JPark82/3xCarbide-Permit-ILK/3xCarbide Permit ILK_Sch(R1.03_1012).pdf

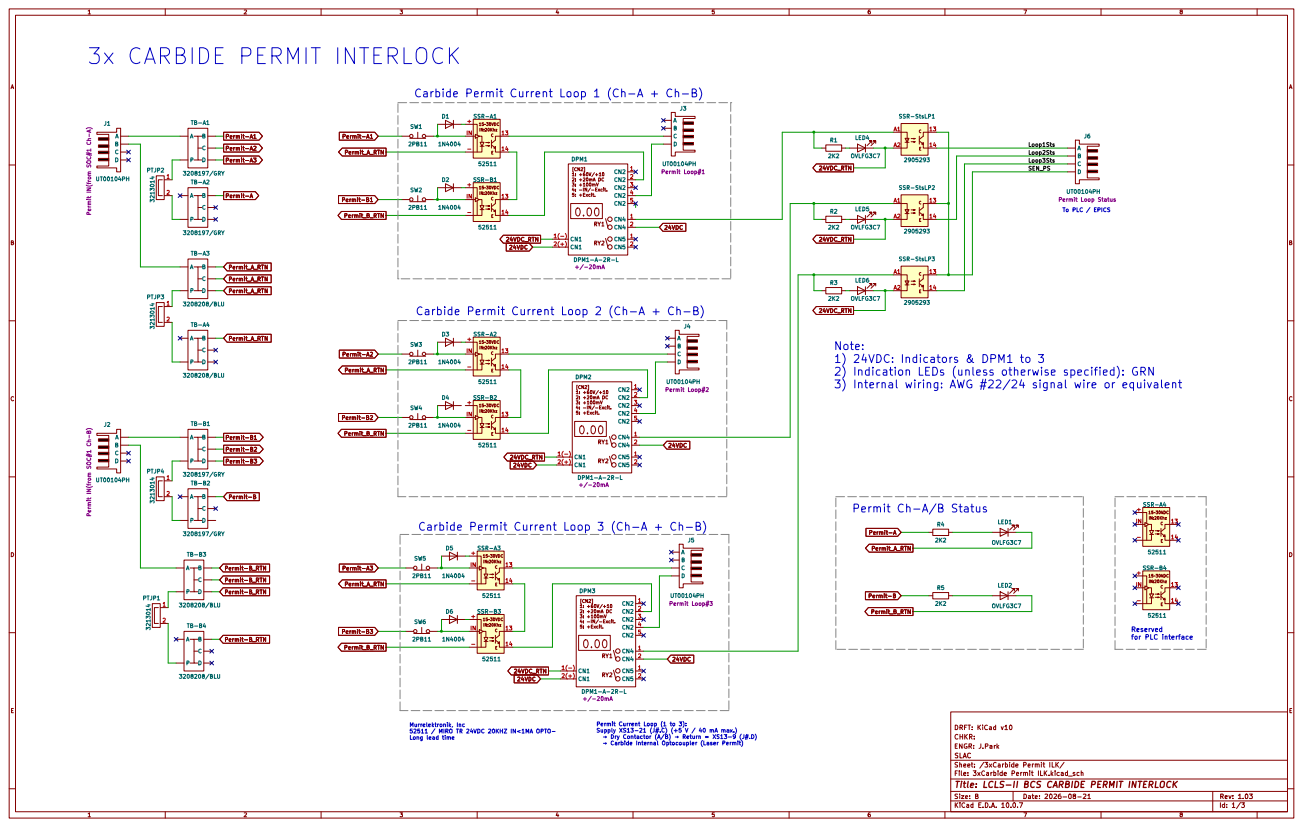
[picture p1: page 1]

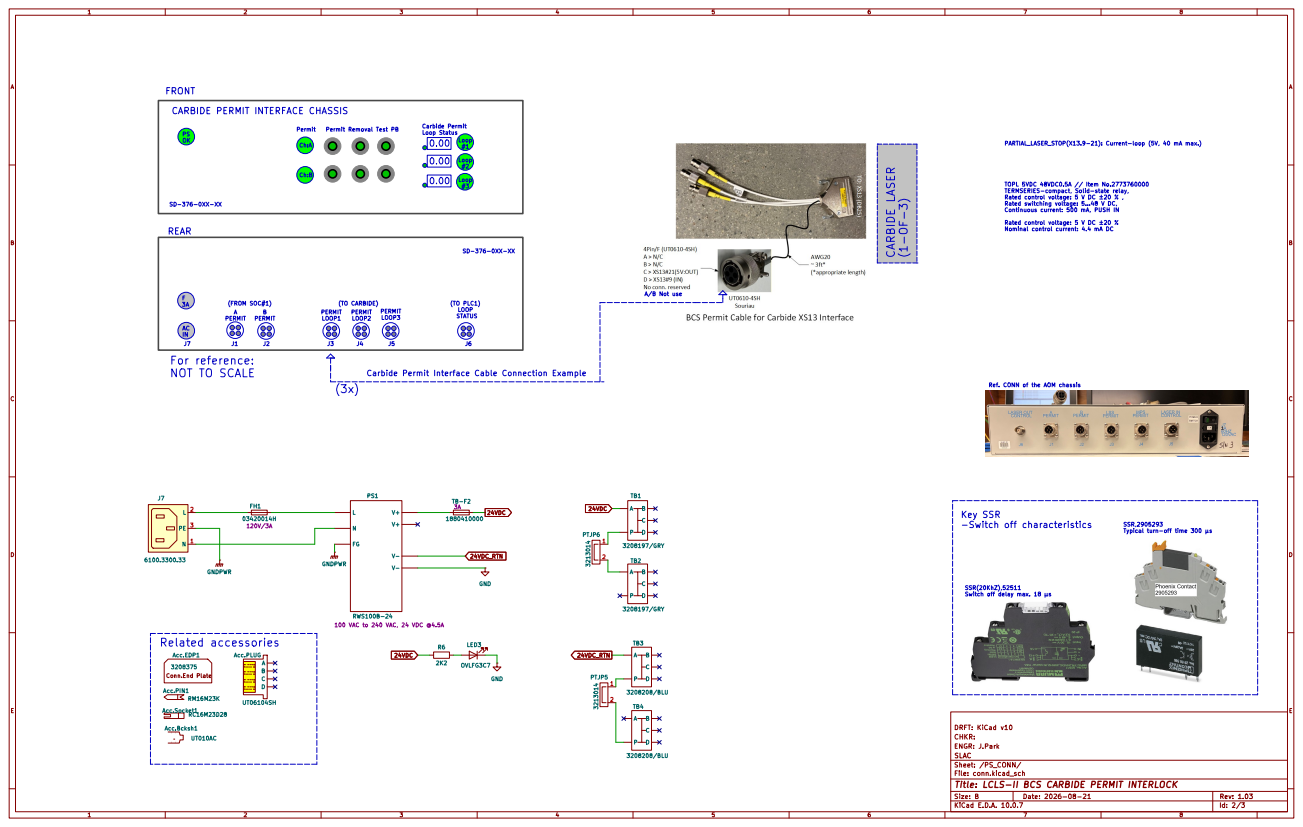
[picture p2: page 2]

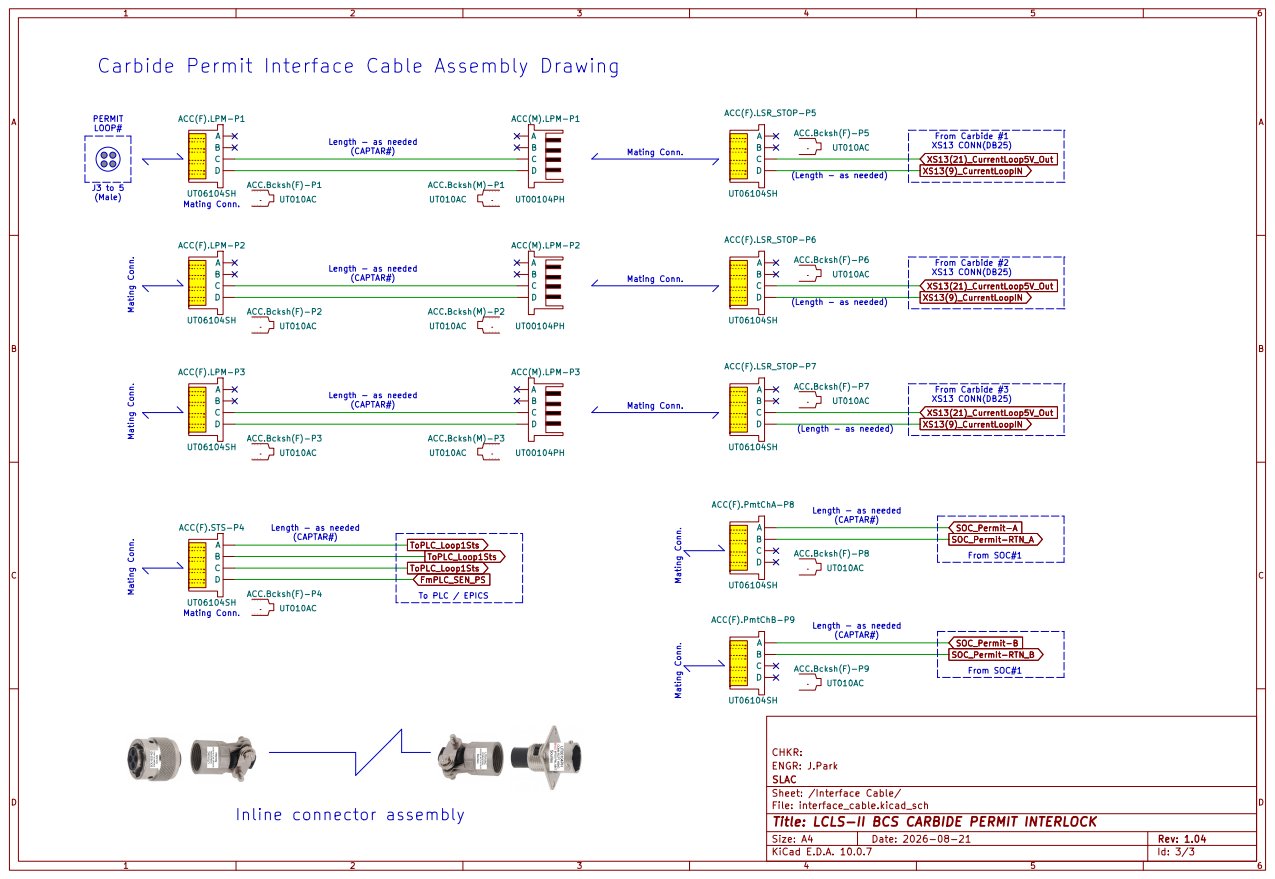
[picture p3: page 3]
