JPark82/3xCarbide-Permit-ILK/3xCarbide Permit ILK_Sch(R1.03_1006).pdf

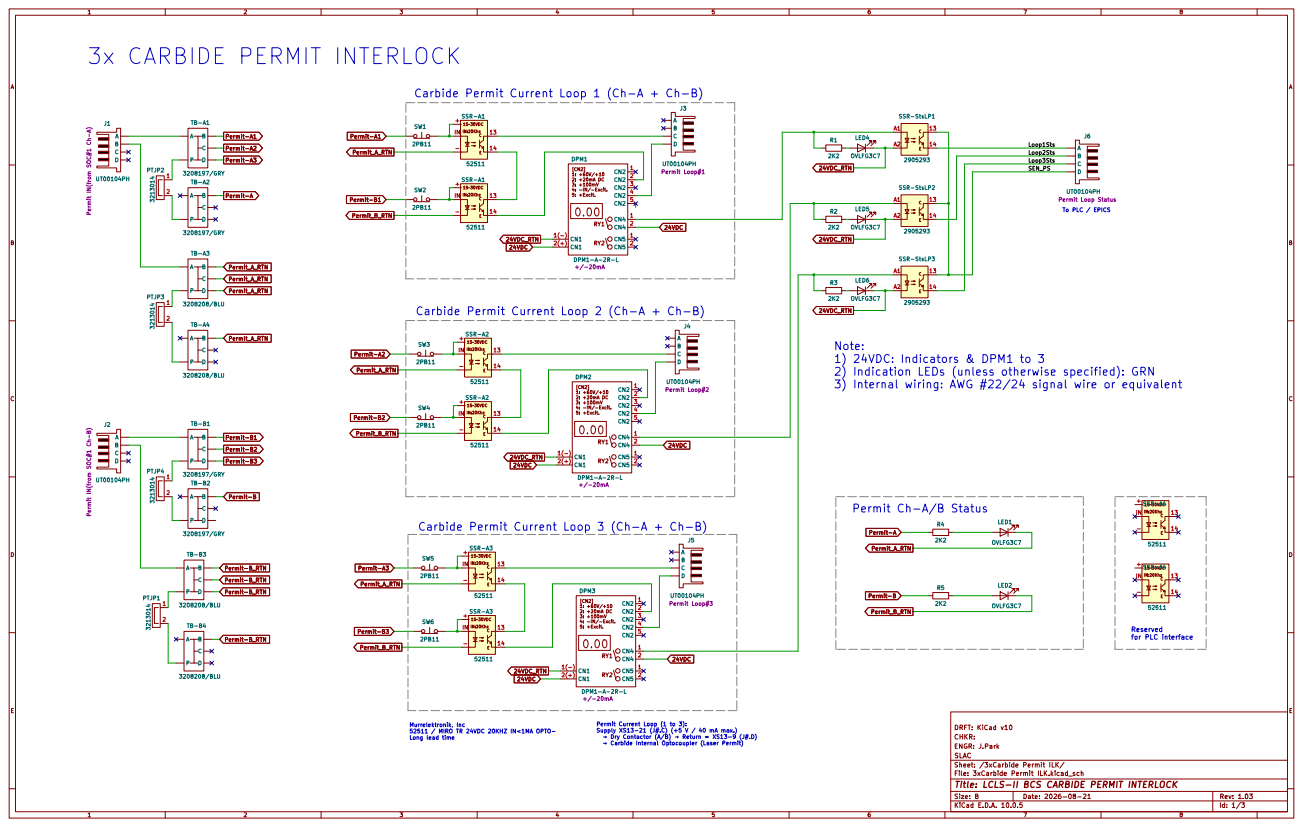
[picture p4: page 1]

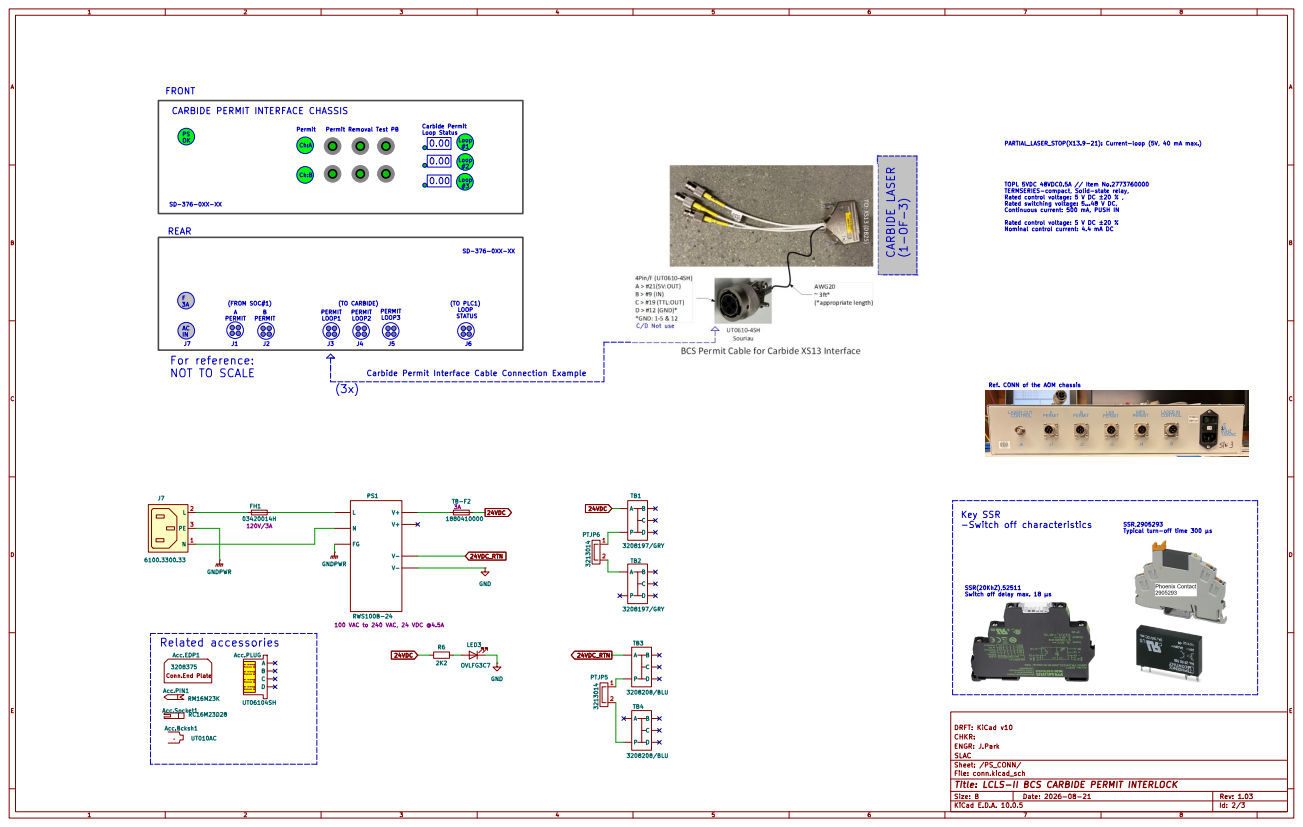
[picture p5: page 2]

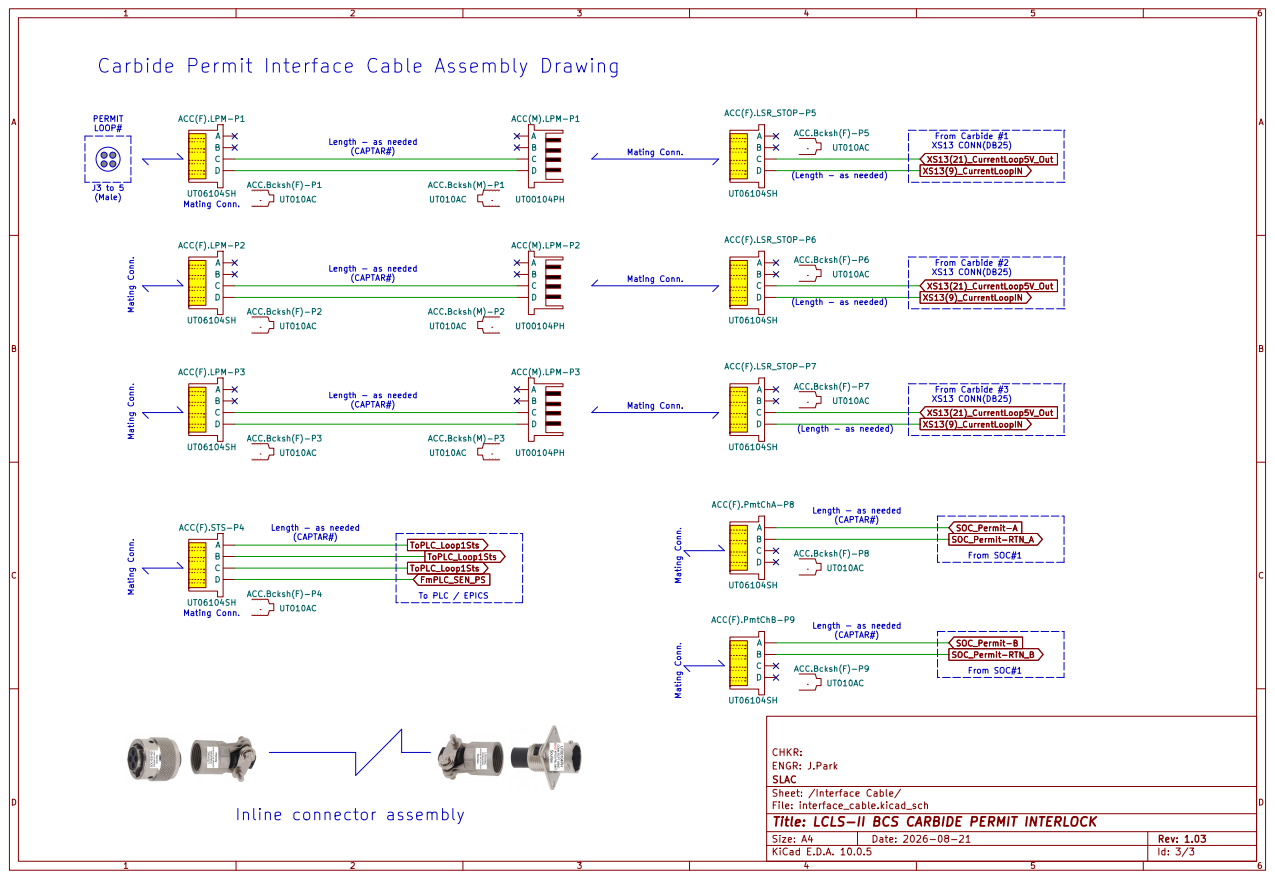
[picture p6: page 3]
