JPark82/3xCarbide-Permit-ILK/3xCarbide Permit ILK_Sch(R1.01_0821).pdf

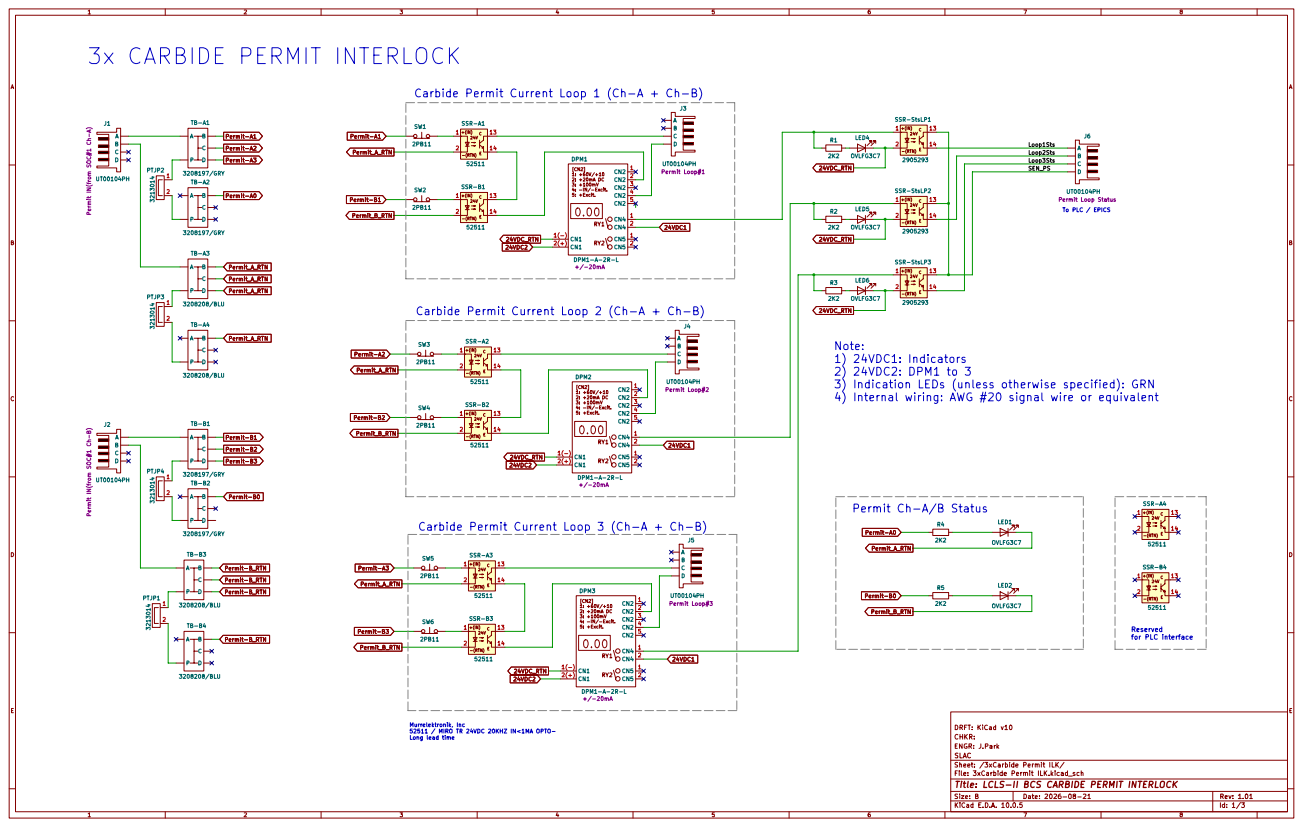
[picture p7: page 1]

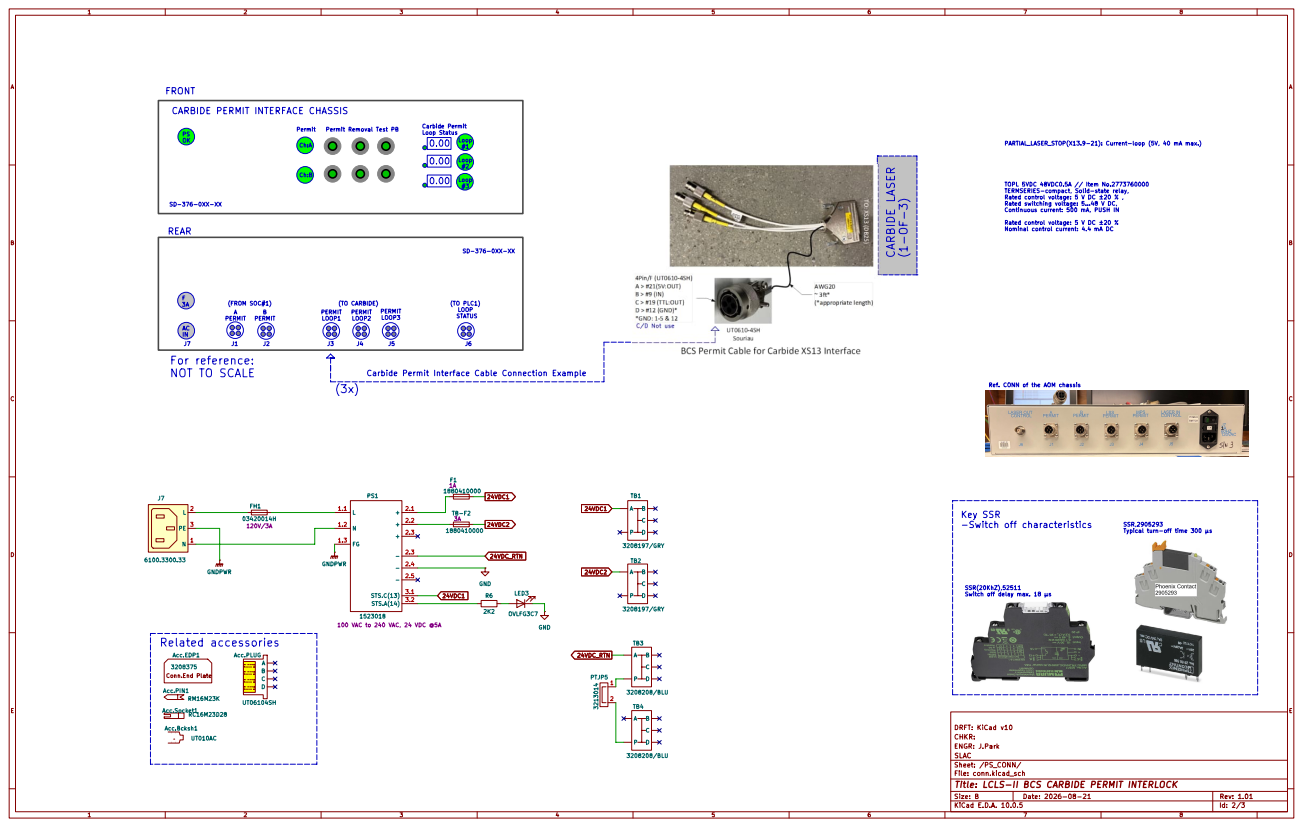
[picture p8: page 2]

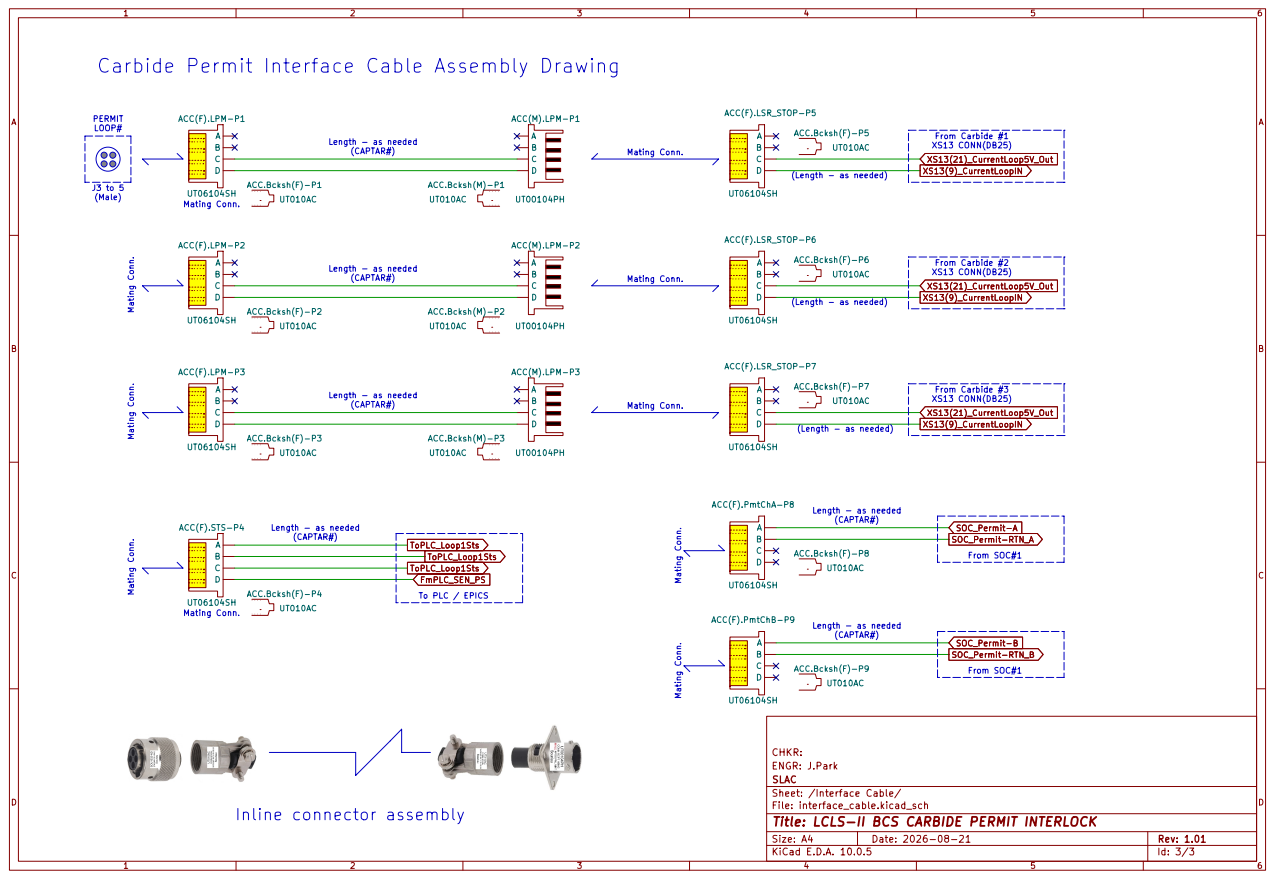
[picture p9: page 3]
