JPark82/3xCarbide-Permit-ILK/3xCarbide Permit ILK_Sch(R1a_0821).pdf

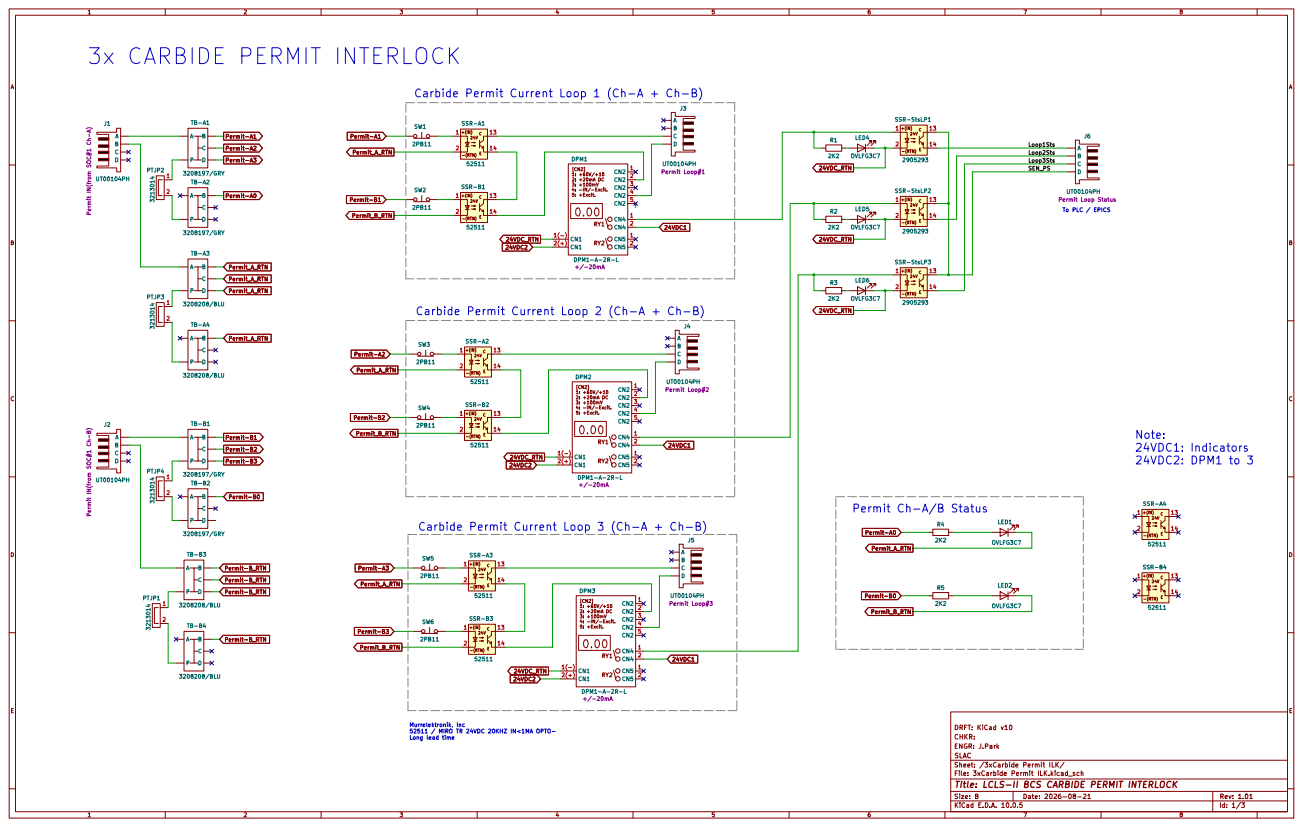
[picture p10: page 1]

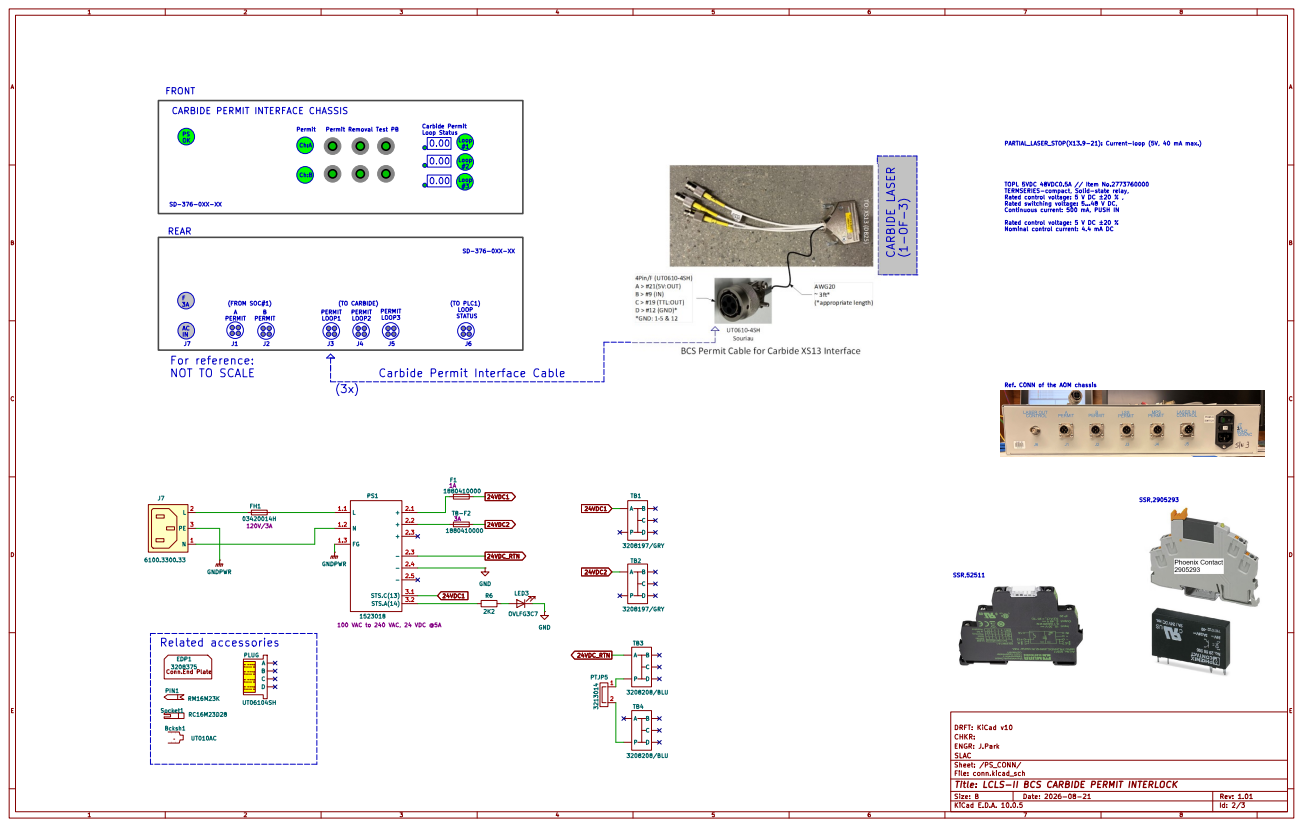
[picture p11: page 2]

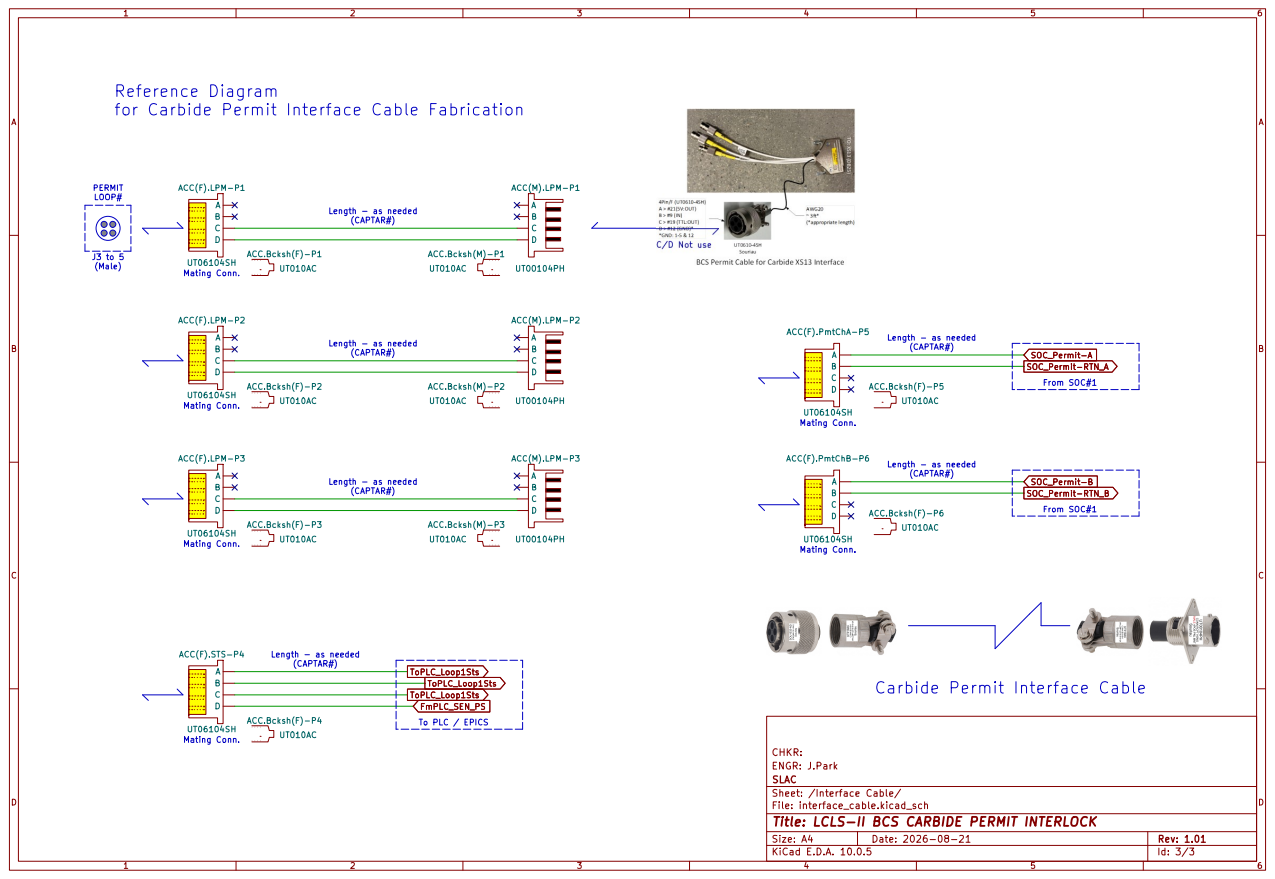
[picture p12: page 3]
