JPark82/3xCarbide-Permit-ILK/3xCarbide Permit ILK_Sch(R1a_0820).pdf

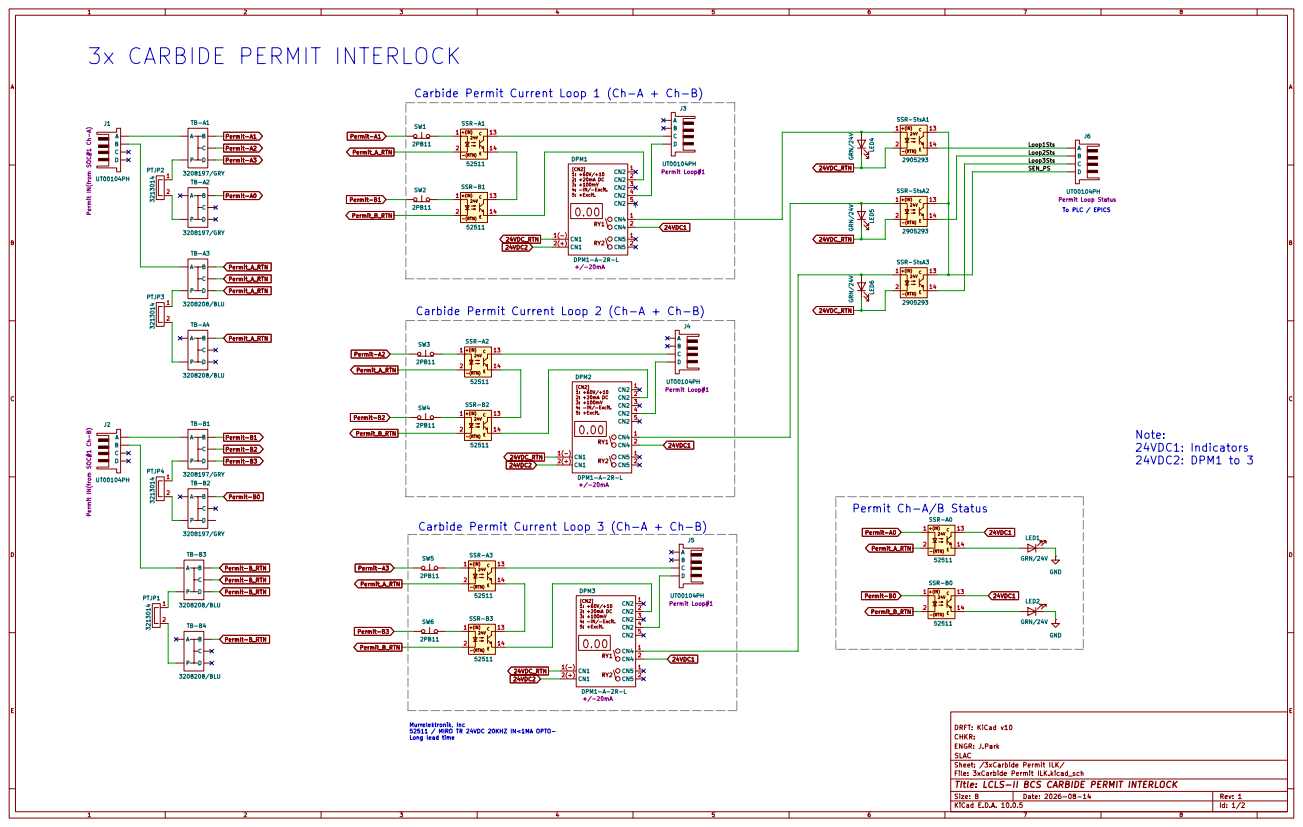
[picture p13: page 1]

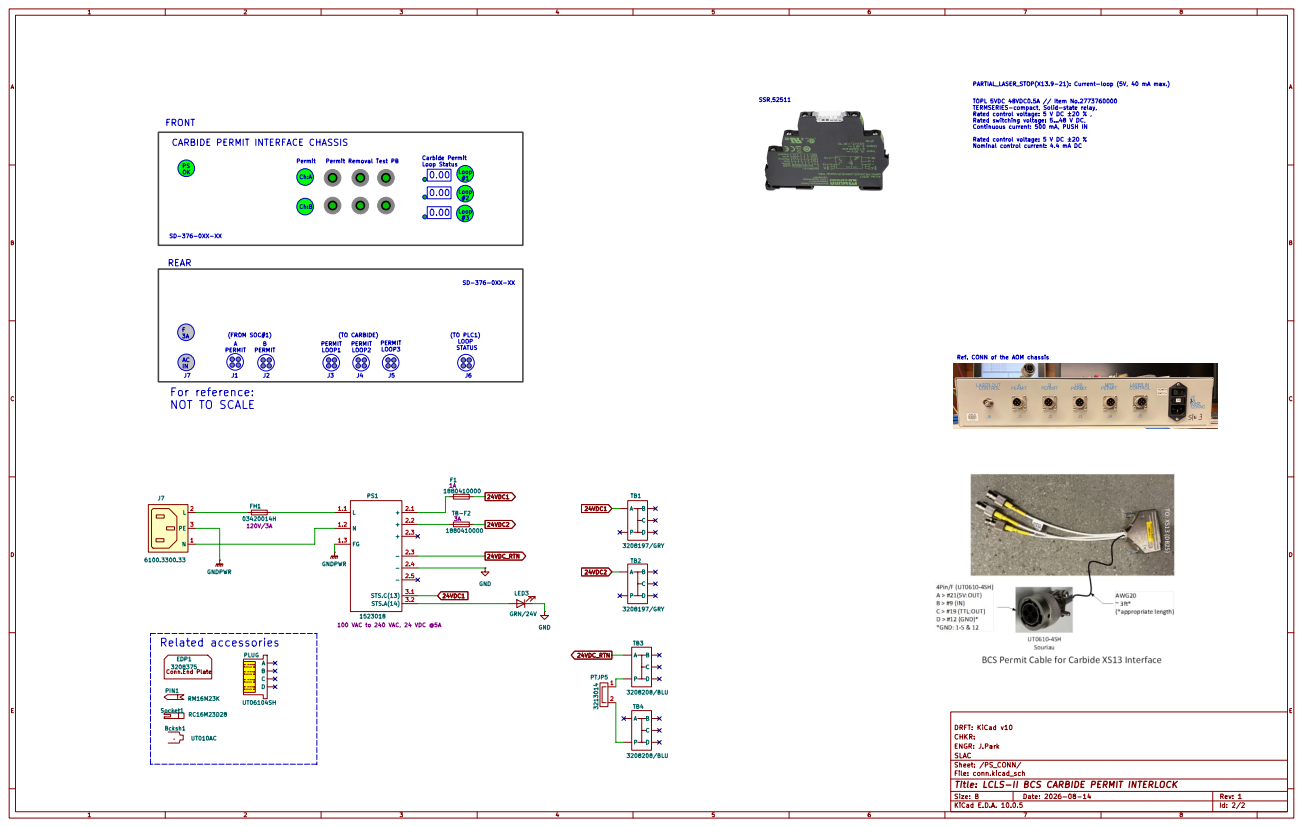
[picture p14: page 2]
