JPark82/3xCarbide-Permit-ILK/3xCarbide Permit ILK_Sch(R1).pdf

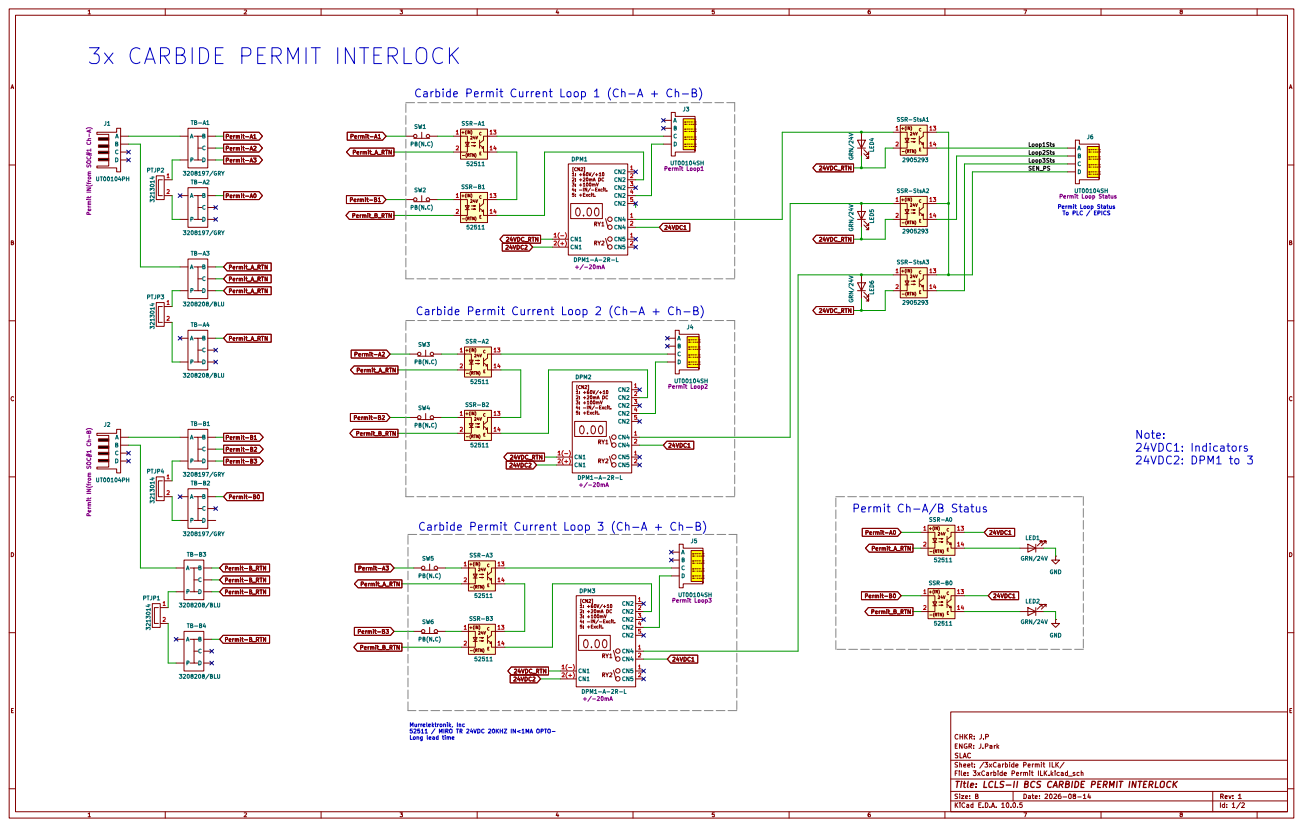
[picture p15: page 1]

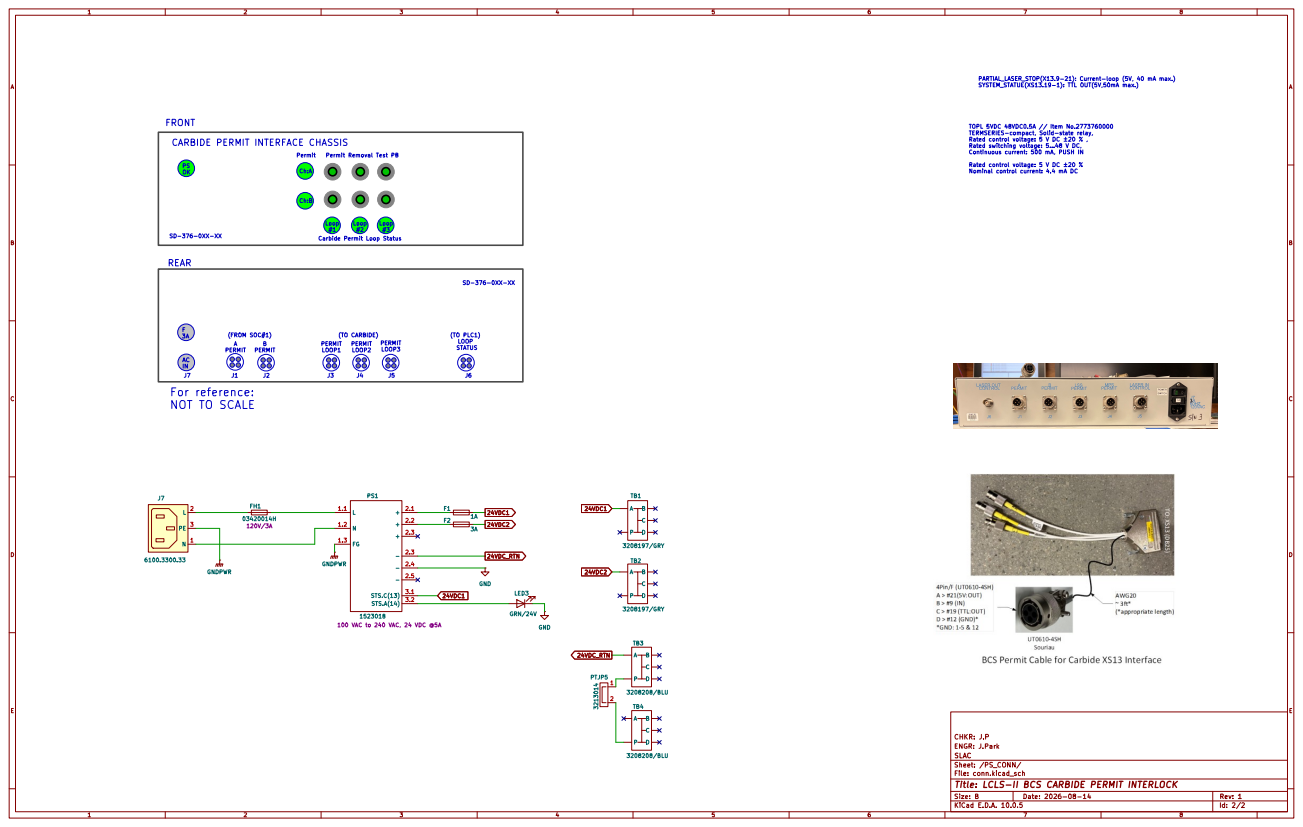
[picture p16: page 2]
