JPark82/3xCarbide-Permit-ILK/3xCarbide Permit ILK_Sch.pdf

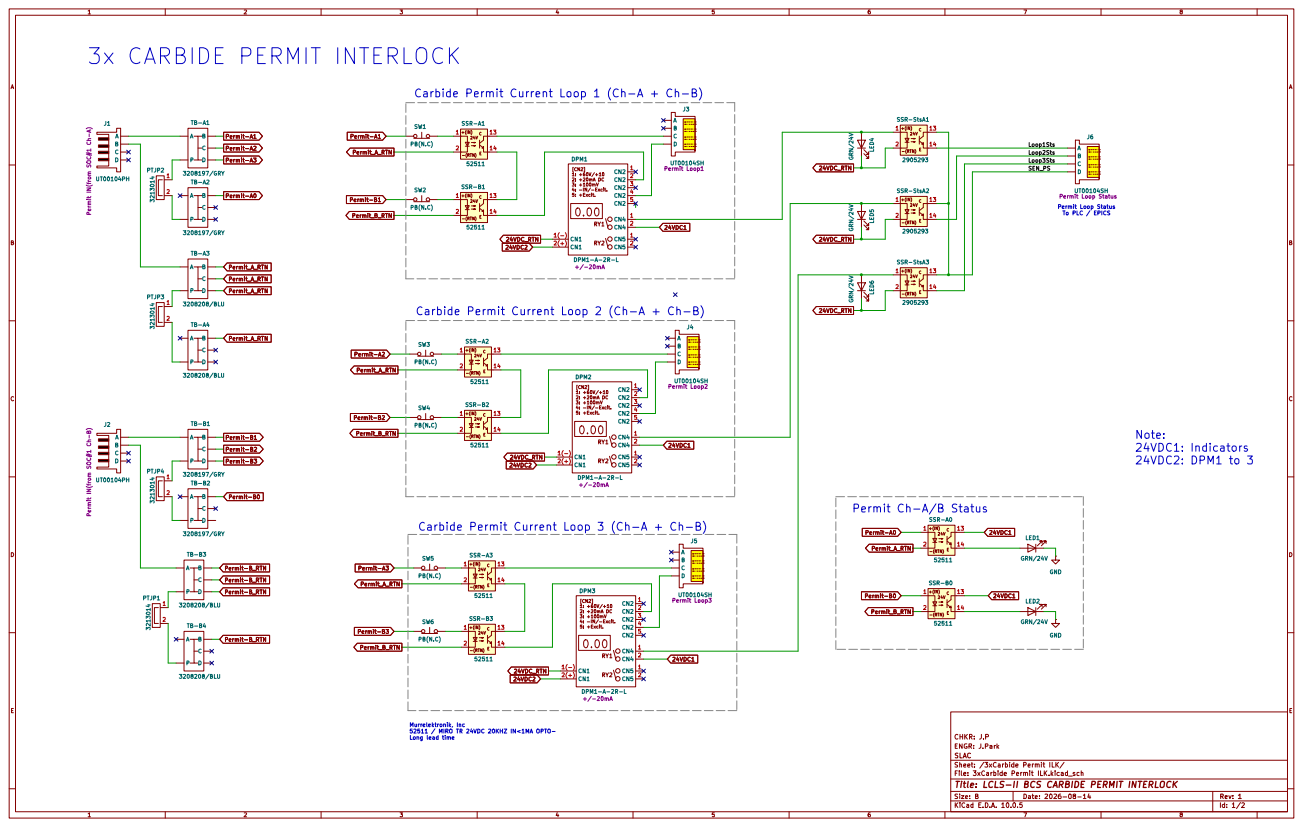
[picture p17: page 1]
