JPark82/3xCarbide-Permit-ILK/3xCarbide Permit ILK.kicad_sch

## KiCad design 3xCarbide Permit ILK.kicad_sch (2026-10-12)

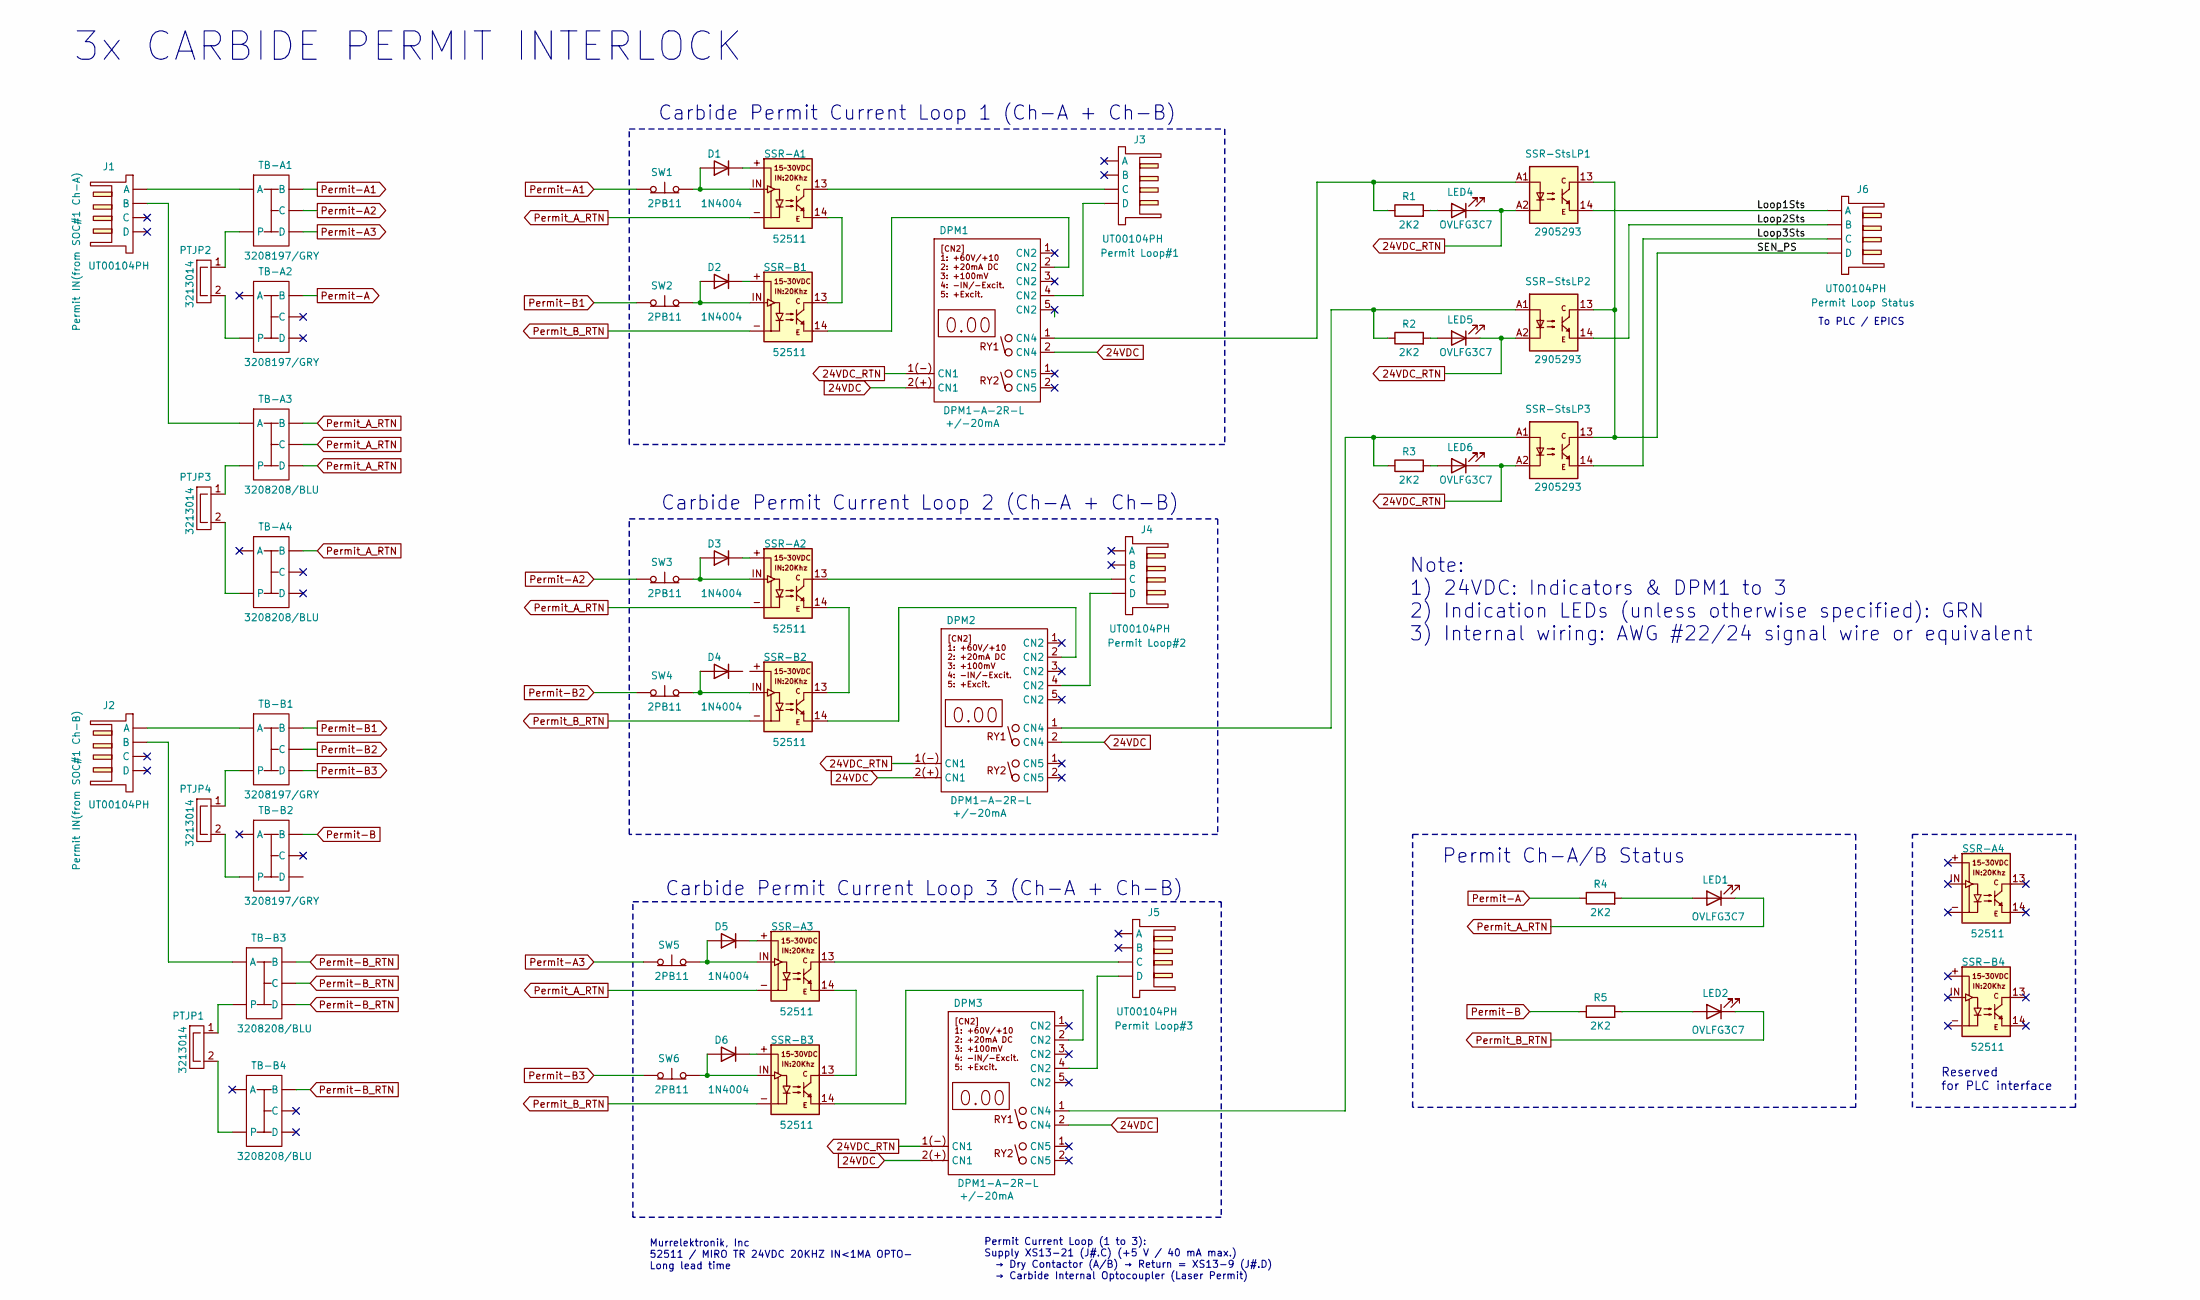
[picture p18: schematic 3xCarbide Permit ILK.kicad_sch]

Parts:
D1, D2, D3, D4, D5, D6: 1N4004; D_DO-41_SOD81_P10.16mm_Horizontal
DPM1, DPM2, DPM3: DPM1-A-2R-L
J1, J2, J3, J4, J5, J6: UT00104PH
LED1, LED2, LED4, LED5, LED6: OVLFG3C7
PTJP1, PTJP2, PTJP3, PTJP4: 3213014
R1, R2, R3, R4, R5: 2K2
SSR-A1, SSR-A2, SSR-A3, SSR-A4: 52511
SSR-B1, SSR-B2, SSR-B3, SSR-B4: 52511
SSR-StsLP1, SSR-StsLP2, SSR-StsLP3: 2905293
SW1, SW2, SW3, SW4, SW5, SW6: 2PB11
TB-A1, TB-A2: 3208197/GRY
TB-A3, TB-A4: 3208208/BLU
TB-B1, TB-B2: 3208197/GRY
TB-B3, TB-B4: 3208208/BLU

Connections:
24VDC: DPM1.2 (CN2), DPM1.2(+) (CN1), DPM2.2 (CN2), DPM2.2(+) (CN1), DPM3.2 (CN2), DPM3.2(+) (CN1)
24VDC_RTN: DPM1.1(-) (CN1), DPM2.1(-) (CN1), DPM3.1(-) (CN1), LED4.1 (K), LED5.1 (K), LED6.1 (K), SSR-StsLP1.A2, SSR-StsLP2.A2, SSR-StsLP3.A2
Loop1Sts: J6., SSR-StsLP1.14
Loop2Sts: J6., SSR-StsLP2.14
Loop3Sts: J6., SSR-StsLP3.14
unnamed: D1.1 (K), SSR-A1.+
unnamed: D1.2 (A), SSR-A1.IN, SW1.2 (B)
unnamed: D2.1 (K), SSR-B1.+
unnamed: D2.2 (A), SSR-B1.IN, SW2.2 (B)
unnamed: D3.1 (K), SSR-A2.+
unnamed: D3.2 (A), SSR-A2.IN, SW3.2 (B)
unnamed: D4.2 (A), SSR-B2.IN, SW4.2 (B)
unnamed: D5.1 (K), SSR-A3.+
unnamed: D5.2 (A), SSR-A3.IN, SW5.2 (B)
unnamed: D6.1 (K), SSR-B3.+
unnamed: D6.2 (A), SSR-B3.IN, SW6.2 (B)
unnamed: DPM1.1 (CN2), R1.1, SSR-StsLP1.A1
unnamed: DPM1.2 (CN2), SSR-B1.14
unnamed: DPM1.4 (CN2), J3.
unnamed: DPM2.1 (CN2), R2.1, SSR-StsLP2.A1
unnamed: DPM2.2 (CN2), SSR-B2.14
unnamed: DPM2.4 (CN2), J4.
unnamed: DPM3.1 (CN2), R3.1, SSR-StsLP3.A1
unnamed: DPM3.2 (CN2), SSR-B3.14
unnamed: DPM3.4 (CN2), J5.
unnamed: J1., TB-A1., TB-A3.
unnamed: J2., TB-B1., TB-B3.
unnamed: J3., SSR-A1.13
unnamed: J4., SSR-A2.13
unnamed: J5., SSR-A3.13
unnamed: LED1.2 (A), R4.2
unnamed: LED2.2 (A), R5.2
unnamed: LED4.2 (A), R1.2
unnamed: LED5.2 (A), R2.2
unnamed: LED6.2 (A), R3.2
unnamed: PTJP1.1, TB-B3.
unnamed: PTJP1.2, TB-B4.
unnamed: PTJP2.1, TB-A1.
unnamed: PTJP2.2, TB-A2.
unnamed: PTJP3.1, TB-A3.
unnamed: PTJP3.2, TB-A4.
unnamed: PTJP4.1, TB-B1.
unnamed: PTJP4.2, TB-B2.
unnamed: SSR-A1.14, SSR-B1.13
unnamed: SSR-A2.14, SSR-B2.13
unnamed: SSR-A3.14, SSR-B3.13
Permit-A: R4.1, TB-A2.
Permit-A1: SW1.1 (A), TB-A1.
Permit-A2: SW3.1 (A), TB-A1.
Permit-A3: SW5.1 (A), TB-A1.
Permit-B: R5.1, TB-B2.
Permit-B1: SW2.1 (A), TB-B1.
Permit-B2: SW4.1 (A), TB-B1.
Permit-B3: SW6.1 (A), TB-B1.
Permit-B_RTN: TB-B3., TB-B4.
Permit_A_RTN: LED1.1 (K), SSR-A1.-, SSR-A2.-, SSR-A3.-, TB-A3., TB-A4.
Permit_B_RTN: LED2.1 (K), SSR-B1.-, SSR-B2.-, SSR-B3.-
SEN_PS: J6., SSR-StsLP1.13, SSR-StsLP2.13, SSR-StsLP3.13

Notes on the sheet:
3x CARBIDE PERMIT INTERLOCK
Note: 1) 24VDC: Indicators & DPM1 to 3 2) Indication LEDs (unless otherwise specified): GRN 3) Internal wiring: AWG #22/24 signal wire or equivalent
Carbide Permit Current Loop 1 (Ch-A + Ch-B)
Reserved for PLC interface
Carbide Permit Current Loop 3 (Ch-A + Ch-B)
Permit Current Loop (1 to 3): Supply XS13-21 (J#.C) (+5 V / 40 mA max.) → Dry Contactor (A/B) → Return = XS13-9 (J#.D) → Carbide Internal Optocoupler (Laser Permit)
Carbide Permit Current Loop 2 (Ch-A + Ch-B)
To PLC / EPICS
Murrelektronik, Inc 52511 / MIRO TR 24VDC 20KHZ IN<1MA OPTO- Long lead time
Permit Ch-A/B Status
