JPark82/3xCarbide-Permit-ILK/conn.kicad_sch

## KiCad design conn.kicad_sch (2026-10-12)

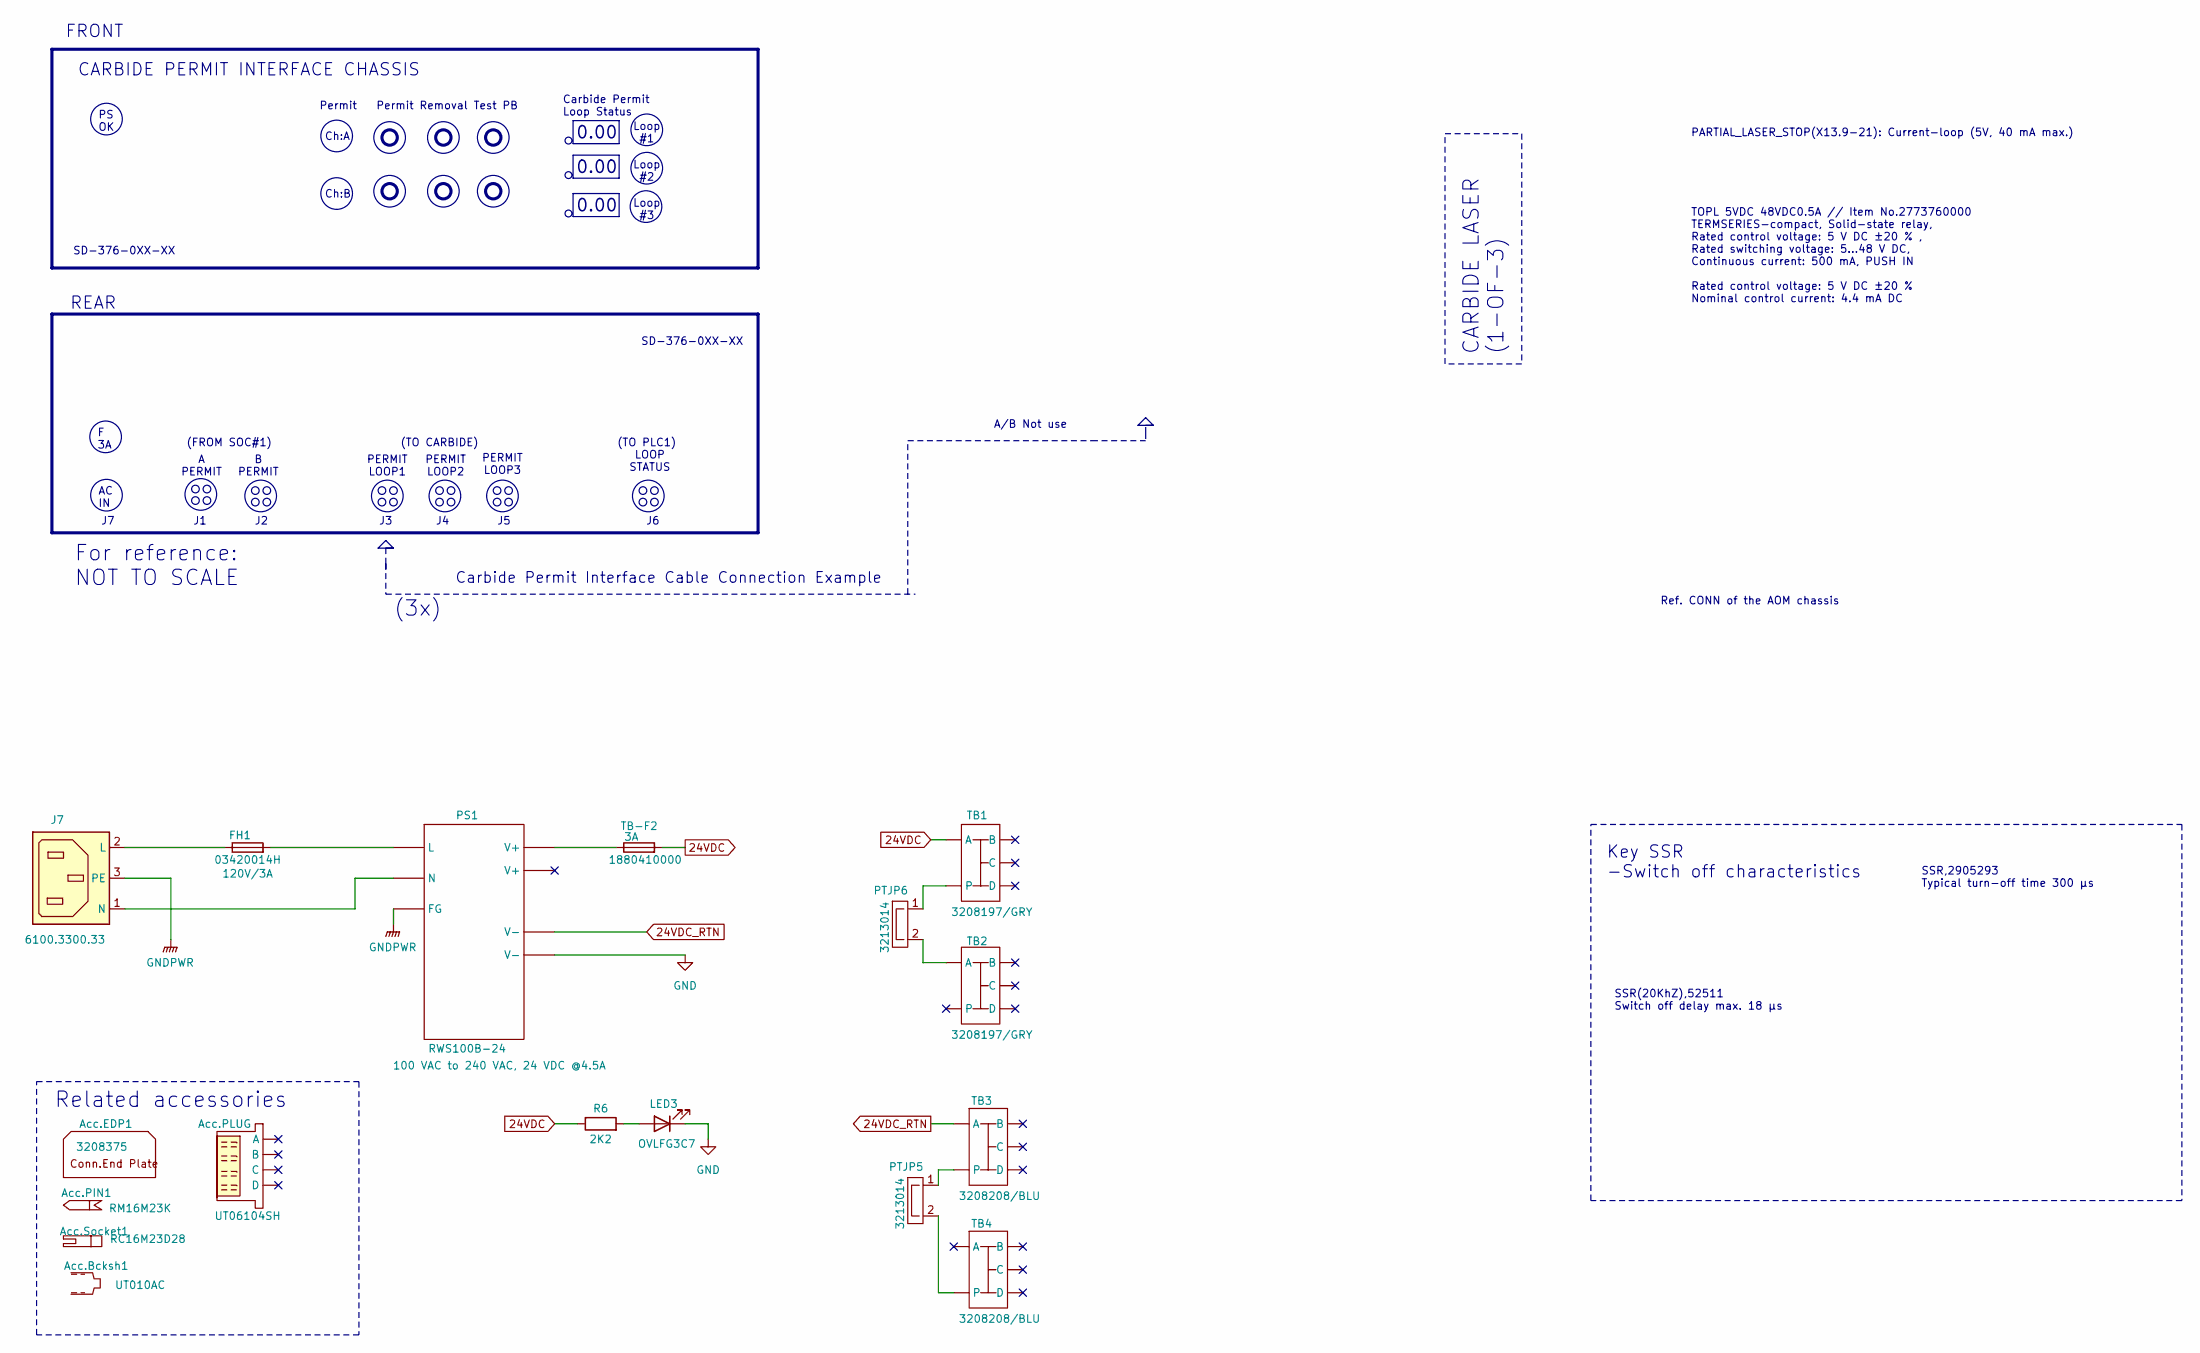
[picture p19: schematic conn.kicad_sch]

Parts:
Acc.Bcksh1: UT010AC
Acc.EDP1: 3208375
Acc.PIN1: RM16M23K
Acc.PLUG: UT06104SH
Acc.Socket1: RC16M23D28
FH1: 03420014H
J7: 6100.3300.33
LED3: OVLFG3C7
PS1: RWS100B-24
PTJP5, PTJP6: 3213014
R6: 2K2
TB1, TB2: 3208197/GRY
TB3, TB4: 3208208/BLU
TB-F2: 1880410000

Connections:
24VDC: R6.1, TB1., TB-F2.2
24VDC_RTN: PS1., TB3.
GND: LED3.1 (K), PS1.
GNDPWR: J7.3 (PE), PS1.
unnamed: FH1.1, J7.2 (L)
unnamed: FH1.2, PS1.
unnamed: J7.1 (N), PS1.
unnamed: LED3.2 (A), R6.2
unnamed: PS1., TB-F2.1
unnamed: PTJP5.1, TB3.
unnamed: PTJP5.2, TB4.
unnamed: PTJP6.1, TB1.
unnamed: PTJP6.2, TB2.

Notes on the sheet:
TOPL 5VDC 48VDC0.5A // Item No.2773760000 TERMSERIES-compact, Solid-state relay, Rated control voltage: 5 V DC ±20 % , Rated switching voltage: 5...48 V DC, Continuous current: 500 mA, PUSH IN Rated control voltage: 5 V DC ±20 % Nominal control current: 4.4 mA DC
Loop #3
Permit Removal Test PB
(TO PLC1)
Related accessories
Ch:B
Ref. CONN of the AOM chassis
A PERMIT
Loop #1
LOOP STATUS
(TO CARBIDE)
(FROM SOC#1)
Carbide Permit Loop Status
0.00
PERMIT LOOP2
B PERMIT
SD-376-0XX-XX
For reference: NOT TO SCALE
PS OK
SSR,2905293 Typical turn-off time 300 µs
Key SSR -Switch off characteristics
PERMIT LOOP1
PERMIT LOOP3
A/B Not use
Ch:A
CARBIDE PERMIT INTERFACE CHASSIS
(3x)
CARBIDE LASER (1-OF-3)
PARTIAL_LASER_STOP(X13.9-21): Current-loop (5V, 40 mA max.)
AC IN
Carbide Permit Interface Cable Connection Example
Permit
F 3A
SSR(20KhZ),52511 Switch off delay max. 18 µs
Loop #2
FRONT
REAR
