JPark82/3xCarbide-Permit-ILK/interface_cable.kicad_sch

## KiCad design interface_cable.kicad_sch (2026-10-12)

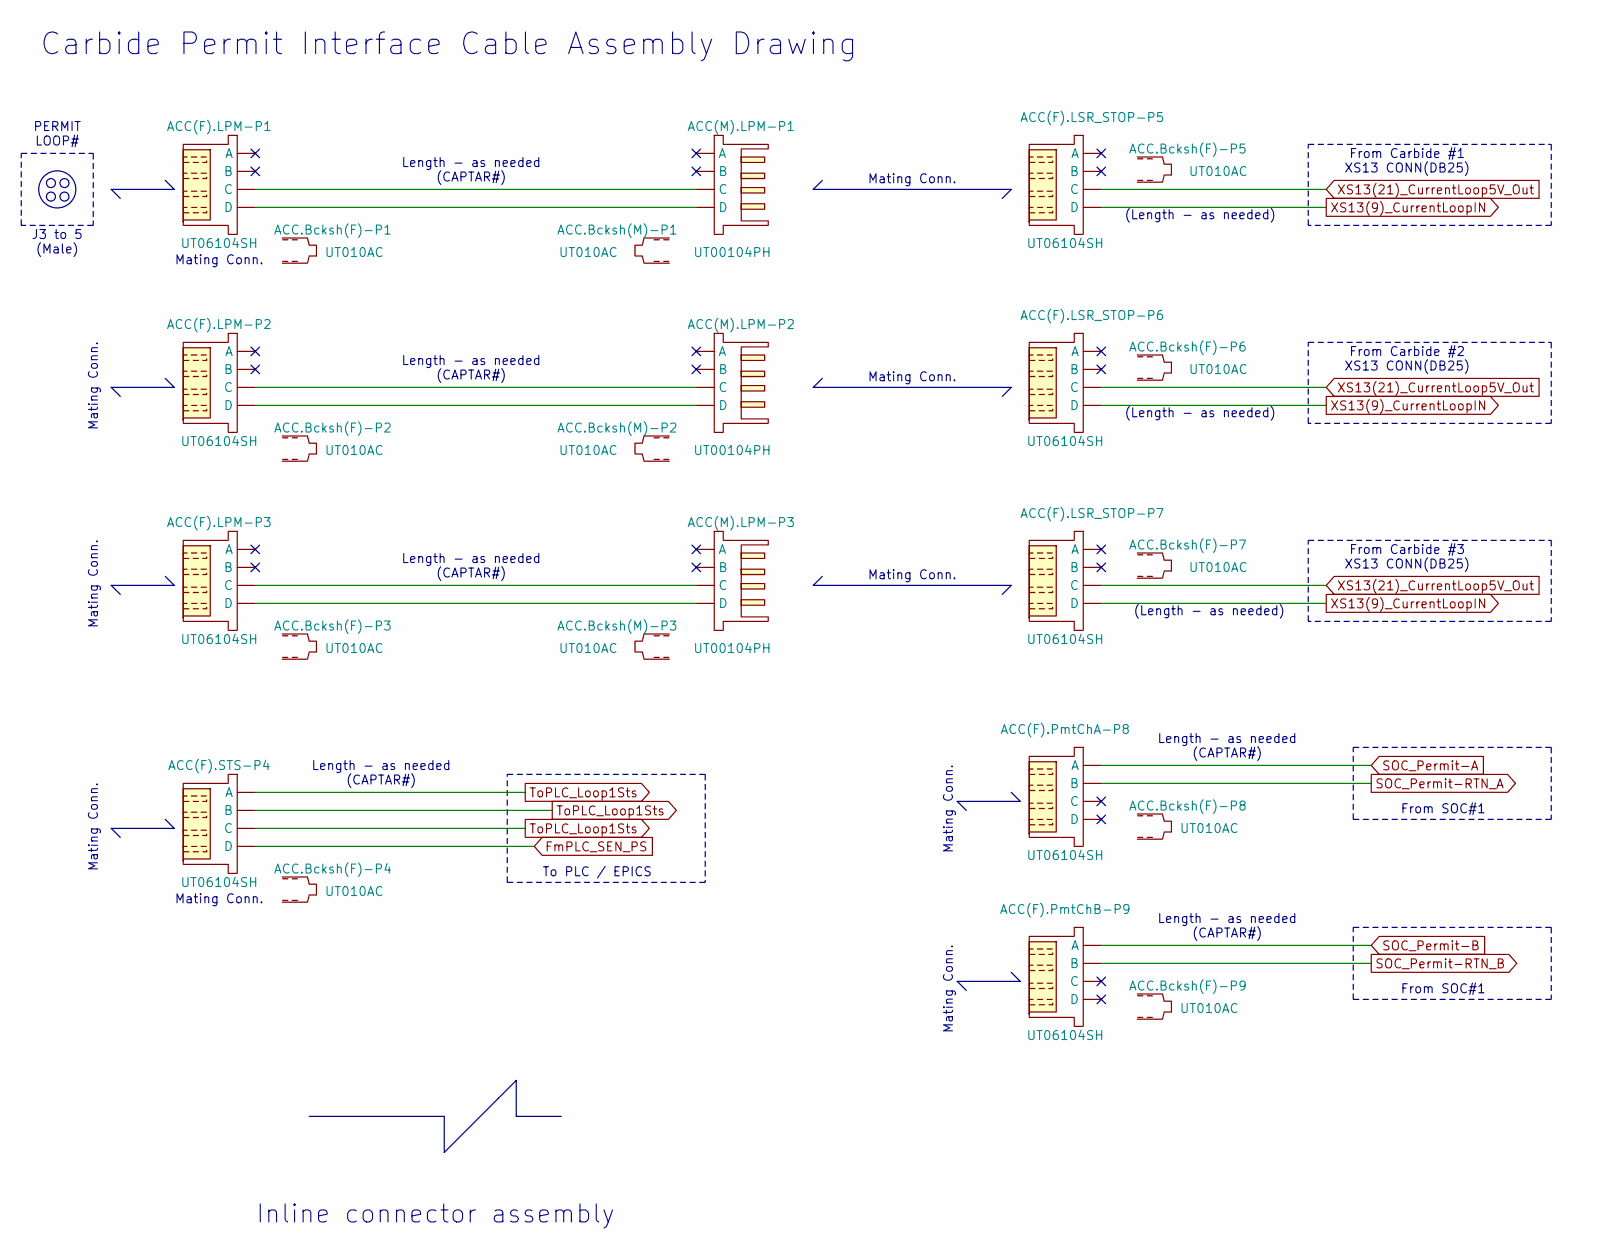
[picture p20: schematic interface_cable.kicad_sch]

Parts:
ACC(F).LPM-P1, ACC(F).LPM-P2, ACC(F).LPM-P3, ACC(F).LSR_STOP-P5, ACC(F).LSR_STOP-P6, ACC(F).LSR_STOP-P7, ACC(F).PmtChA-P8, ACC(F).PmtChB-P9, ACC(F).STS-P4: UT06104SH
ACC(M).LPM-P1, ACC(M).LPM-P2, ACC(M).LPM-P3: UT00104PH
ACC.Bcksh(F)-P1, ACC.Bcksh(F)-P2, ACC.Bcksh(F)-P3, ACC.Bcksh(F)-P4, ACC.Bcksh(F)-P5, ACC.Bcksh(F)-P6, ACC.Bcksh(F)-P7, ACC.Bcksh(F)-P8, ACC.Bcksh(F)-P9, ACC.Bcksh(M)-P1, ACC.Bcksh(M)-P2, ACC.Bcksh(M)-P3: UT010AC

Connections:
FmPLC_SEN_PS: ACC(F).STS-P4.
unnamed: ACC(F).LPM-P1., ACC(M).LPM-P1.
unnamed: ACC(F).LPM-P2., ACC(M).LPM-P2.
unnamed: ACC(F).LPM-P3., ACC(M).LPM-P3.
SOC_Permit-A: ACC(F).PmtChA-P8.
SOC_Permit-B: ACC(F).PmtChB-P9.
SOC_Permit-RTN_A: ACC(F).PmtChA-P8.
SOC_Permit-RTN_B: ACC(F).PmtChB-P9.
ToPLC_Loop1Sts: ACC(F).STS-P4.
XS13(9)_CurrentLoopIN: ACC(F).LSR_STOP-P5., ACC(F).LSR_STOP-P6., ACC(F).LSR_STOP-P7.
XS13(21)_CurrentLoop5V_Out: ACC(F).LSR_STOP-P5., ACC(F).LSR_STOP-P6., ACC(F).LSR_STOP-P7.

Notes on the sheet:
Mating Conn.
To PLC / EPICS
Length - as needed (CAPTAR#)
PERMIT LOOP#
Carbide Permit Interface Cable Assembly Drawing
From Carbide #2 XS13 CONN(DB25)
(Length - as needed)
From Carbide #1 XS13 CONN(DB25)
From SOC#1
J3 to 5 (Male)
Inline connector assembly
From Carbide #3 XS13 CONN(DB25)
