JPark82/3xCarbide-Permit-ILK/(commit log)

2026-08-14 Init 3x Carbide ILK (R1)
    [.kicad_sch, .kicad_sch.kicad_sch, 3xCarbide Permit ILK.csv, 3xCarbide Permit ILK.kicad_sch, conn.kicad_sch]
2026-08-15 Updated BoM
    [.kicad_sch.kicad_sch, 3xCarbide Permit ILK.kicad_sch, conn.kicad_sch]
2026-08-15 Updated PB SW Part#
    [3xCarbide Permit ILK.kicad_sch, conn.kicad_sch]
2026-08-15 Updated BOM with PB switch
    [3xCarbide Permit ILK.csv]
2026-08-17 Added DRFT
    [3xCarbide Permit ILK.kicad_sch, conn.kicad_sch]
2026-08-17 Added accessary
    [3xCarbide Permit ILK(BOM).xlsx, 3xCarbide Permit ILK.kicad_sch, conn.kicad_sch]
2026-08-17 Update PB with Honeywell 2PB11
    [3xCarbide Permit ILK.csv, 3xCarbide Permit ILK.kicad_sch, conn.kicad_sch]
2026-08-17 Updated BOM with Honeywell PB
    [3xCarbide Permit ILK(BOM).xlsx]
2026-08-20 Update Murre SSR 52511 vendor
    [3xCarbide Permit ILK.kicad_sch]
2026-08-20 Updated Acc. parts
    [3xCarbide Permit ILK.csv, 3xCarbide Permit ILK.kicad_sch, conn.kicad_sch]
2026-08-21 Edit Permit Loop#
    [3xCarbide Permit ILK.kicad_sch]
2026-08-21 Added Interface Cable and etc
    [3xCarbide Permit ILK.csv, 3xCarbide Permit ILK.kicad_sch, conn.kicad_sch, interface_cable.kicad_sch]
2026-08-21 Updated Interface cable
    [3xCarbide Permit ILK(BOM R1a).xlsx, 3xCarbide Permit ILK.csv, 3xCarbide Permit ILK.kicad_sch, conn.kicad_sch, interface_cable.kicad_sch]
2026-08-21 Clean up
    [3xCarbide Permit ILK.kicad_sch, conn.kicad_sch, interface_cable.kicad_sch]
2026-09-30 Updated PS and clean up
    [3xCarbide Permit ILK.kicad_sch, conn.kicad_sch, interface_cable.kicad_sch]
2026-10-06 updated SSR Pin and cleanup
    [3xCarbide Permit ILK.kicad_sch, conn.kicad_sch, interface_cable.kicad_sch]
2026-10-11 added diode on MURR SSR
